Debatrix/eInkPhotoAlbum/server/resource/icons/README.md

# 和风天气图标 QWeather Icons

由于python难以处理SVG图像，将[和风天气图标v1.6.0](https://github.com/qwd/Icons/releases/tag/v1.6.0)中的[部分图标](https://dev.qweather.com/docs/resource/icons/)转换为jpg格式以便于使用。

Since python has difficulty with SVG images, [some icons](https://github.com/qwd/Icons/releases/tag/v1.6.0) in [QWeather Icons v1.6.0](https://dev.qweather.com/docs/resource/icons/) are converted to jpg format for ease of use.

> 注意：图标和图标代码将不断的更新，包括新增、修改和删除，因此你必须对你的程序进行适配，以便在发生变化的时候不会导致错误出现！
> Note: Icons and icon codes will be constantly updated, so it is important that you should adapt your program so that changes do not cause errors when they are updated!
