Debatrix/eInkPhotoAlbum/images/20231208182713.jpg

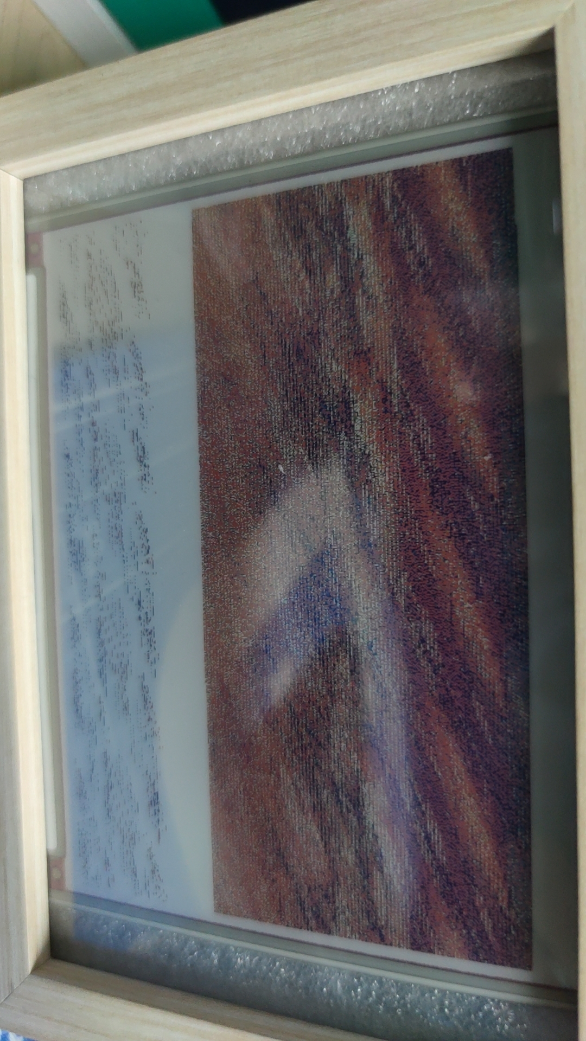
images/20231208182713.jpg
