Debatrix/eInkPhotoAlbum/(threads)

Thread 1 (2023-12-21):

感谢，完成复刻

centralpro, 2023-12-21:
作为折腾爱好者，看到凉糕的文章就下单了，我以为我会，没想到折在了3个函数上
EPD_5IN65F_Display_begin()
EPD_5IN65F_Display_sendData()
EPD_5IN65F_Display_end()

这三个函数官网的示例没有，自己也没有深入看官方的源代码，主要还是不会C

直到搜到了你的代码。。。完美，直接搞定了硬件端
服务端参考你的代码，使用flask实现了一遍

主要功能
1. 主图
2. 每日一句
3. 日历：日期、星期、农历
4. 近3日天气
5. todo list

并实现了可视化配置
配置管理在飞书多维表格
1. 主配置：管理设备id、天气token、todoist token
2. 图片库：设备id、图片附件
3. 每日一句库

每日针对主配置，生成每日配置
1. 随机图片
2. 随机一句话

每10分钟执行一次脚本，重新生成图片
1. 当日图片是否有变化
2. todo list是否有变化
3. 天气是否有变化

墨水屏固定10/30分钟获取下新的图片
感觉还需要设计感一些，还要调整
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

外壳也在制作中了

Thread 2 (2024-10-14):

感谢大佬，完成复刻

daolanx, 2024-10-14:
我也是看了凉糕那篇文章想做，但是并不熟悉 python 和 esp32，找了几个 github仓库，都写的比较杂，您这个仓库代码最简单清晰，于是边调边改。本来是 fork 您的仓库，后来改动太大了，就单独拆开了。感谢分享～

### 我的复刻地址
[daolanx/eink-ai-calendar](https://github.com/daolanx/eink-ai-calendar)

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

Debatrix, 2024-10-16:
磁铁是好设计啊，现在是我的了😂

daolanx, 2024-10-16:
> 磁铁是好设计啊，现在是我的了😂

嗯希望外观好看好用，想了一些组合办法，卡扣，插销，魔术贴，最后还是磁吸好。买的磁铁吸力都比较强，所以做了些磁铁盒子来减少吸力，增大粘胶面积，源文件在/3d 里面。非常感谢大佬分享核心功能，才有机会外观设计～
